mehmetalialkan/T3-Planner/T3-Redstone/mekanik/t3-redstone-outline.dxf

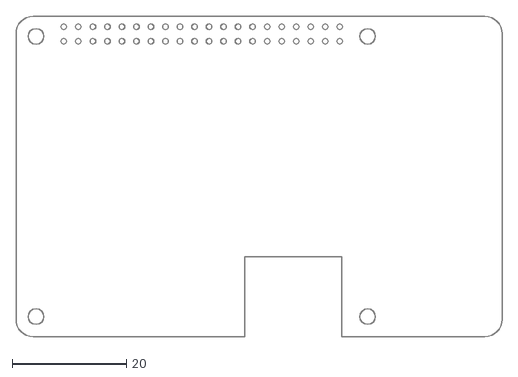
[picture p1: CAD file, 2026-09-13]
T3-Redstone/mekanik/t3-redstone-outline.dxf
85.0 x 56.0
