mehmetalialkan/T3-Planner/T3-Redstone/kicad/t3-redstone.kicad_pcb

## KiCad design T3-Redstone/kicad/t3-redstone.kicad_pcb (2026-09-13)

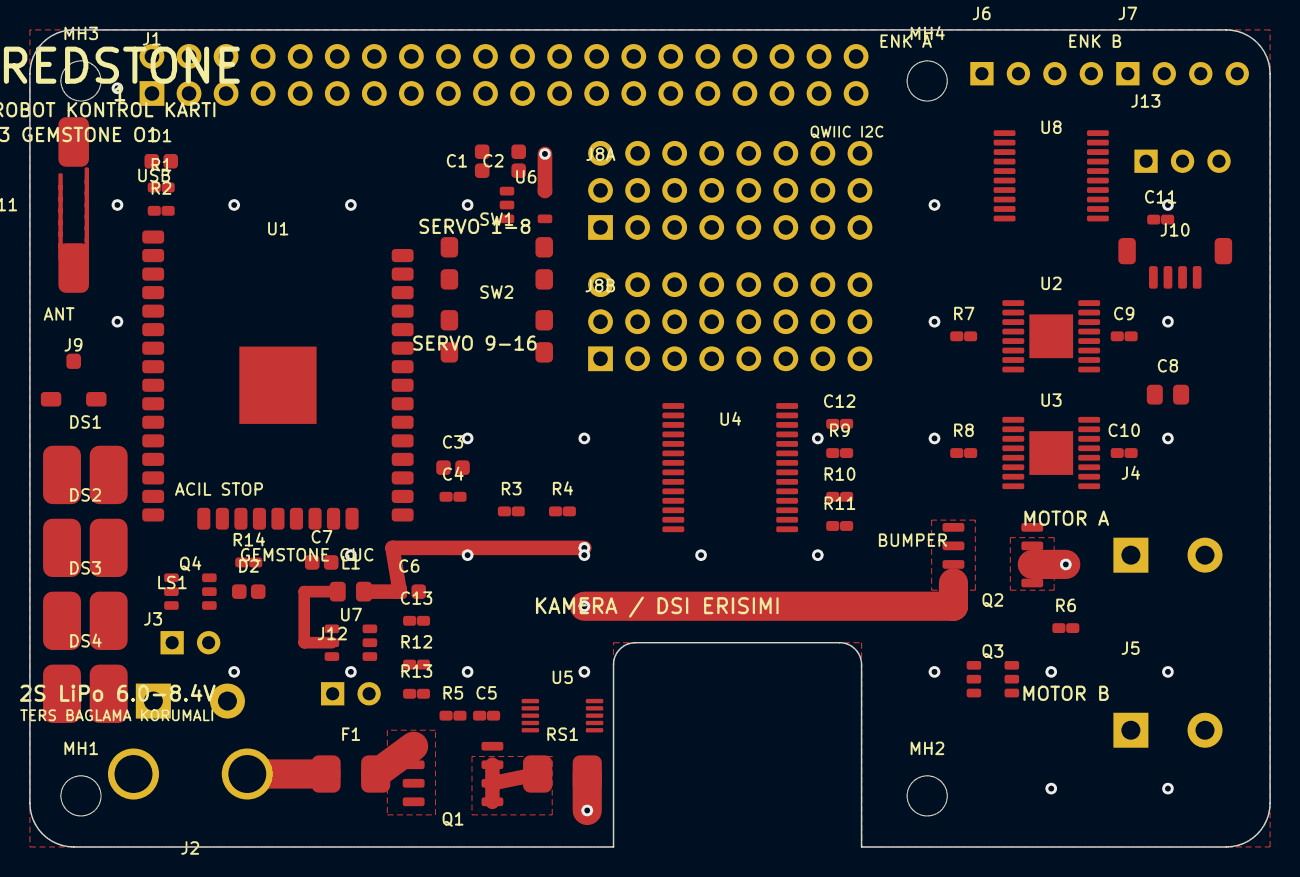
[picture p2: board t3-redstone.kicad_pcb from above]

Board: 4 copper layers, 85.0 x 56.0 mm, 69 parts (0 on the bottom side), 72 nets.

Parts:
C1: 10u; C1
C2: 10u; C2
C3: 22u; C3
C4: 100n; C4
C5: 100n; C5
C6: 22u; C6
C7: 10u; C7
C8: 100u; C8
C9: 100n; C9
C10: 100n; C10
C11: 100n; C11
C12: 100n; C12
C13: 100n; C13
D1: SS14 SOD123; D1
D2: SS14; D2
DS1: WS2812B; DS1
DS2: WS2812B; DS2
DS3: WS2812B; DS3
DS4: WS2812B; DS4
F1: 20A; F1
J1: GEMSTONE_40P_DISI; J1
J2: XT60 2S LiPo; J2
J3: GEMSTONE GUC; J3
J4: MOTOR A; J4
J5: MOTOR B; J5
J6: ENKODER A; J6
J7: ENKODER B; J7
J8A: SERVO 1-8; J8A
J8B: SERVO 9-16; J8B
J9: U.FL ANT; J9
J10: QWIIC; J10
J11: USB-C; J11
J12: ESTOP BUTON; J12
J13: BUMPER; J13
L1: 4u7; L1
LS1: BUZZER; LS1
MH1: M2.5; MH1
MH2: M2.5; MH2
MH3: M2.5; MH3
MH4: M2.5; MH4
Q1: P-MOSFET; Q1
Q2: P-FET ESTOP; Q2
Q3: N-FET SOT23; Q3
Q4: N-FET SOT23; Q4
R1: 5k1; R1
R2: 5k1; R2
R3: 10k; R3
R4: 10k; R4
R5: 100k; R5
R6: 100k; R6
R7: 1k5; R7
R8: 1k5; R8
R9: 10k; R9
R10: 4k7; R10
R11: 4k7; R11
R12: 68k; R12
R13: 10k; R13
R14: 10k; R14
RS1: 2m 2W; RS1
SW1: BOOT; SW1
SW2: RESET; SW2
U1: ESP32-S3-WROOM-1U; U1
U2: DRV8874 A; U2
U3: DRV8874 B; U3
U4: PCA9685; U4
U5: INA226; U5
U6: AP2112K-3.3; U6
U7: TPS563201 5V; U7
U8: 74LVC245; U8

Connections:
+3V3: C2.1, C3.1, C4.1, C5.1, C11.1, C12.1, D2.2, J10.2, LS1.1, R3.2, R4.2, R10.2, R11.2, U1.2, U2.7, U3.7, U4.28, U5.7, U5.10, U6.5, U8.1, U8.20
+5V: C1.1, C6.1, D1.2, J6.1, J7.1, J8A.2, J8A.5, J8A.8, J8A.11, J8A.14, J8A.17, J8A.20, J8A.23, J8B.2, J8B.5, J8B.8, J8B.11, J8B.14, J8B.17, J8B.20, J8B.23, L1.2, R12.1, U6.1, U6.3
+5V_FB: R12.2, R13.1, U7.4
+5V_USB: D1.1, J11.A4, J11.A9, J11.B4, J11.B9
BOOT5V: C13.1, U7.6
BOOT_BTN: SW1.1, SW1.2, U1.27
BUMP1: J13.2, U1.30
BUMP2: J13.3, U1.29
BUZZER: J1.37, Q4.1, R14.1
BUZZER_DRV: D2.1, LS1.2, Q4.3
CC1: J11.A5, R1.1
CC2: J11.B5, R2.1
DRV_nFAULT: R4.1, U1.9, U2.5, U3.5
DRV_nSLEEP: U1.8, U2.2, U3.2
EN: R3.1, SW2.1, SW2.2, U1.3
ENC_A1: U1.12, U8.18
ENC_A1_5V: J6.3, U8.2
ENC_A2: U1.11, U8.16
ENC_A2_5V: J7.3, U8.4
ENC_B1: U1.10, U8.17
ENC_B1_5V: J6.4, U8.3
ENC_B2: U1.17, U8.15
ENC_B2_5V: J7.4, U8.5
ESTOP_BTN: J12.1, U1.32
ESTOP_DRV: Q3.1, U1.23
ESTOP_GATE: Q2.4, Q3.3, R6.1
ESTOP_STAT: J1.13, U1.20
GND: C1.2, C2.2, C3.2, C4.2, C5.2, C6.2, C7.2, C8.2, C9.2, C10.2, C11.2, C12.2, J1.6, J1.9, J1.14, J1.20, J1.25, J1.30, J1.34, J1.39, J2.2, J3.2, J6.2, J7.2, J8A.3, J8A.6, J8A.9, J8A.12, J8A.15, J8A.18, J8A.21, J8A.24, J8B.3, J8B.6, J8B.9, J8B.12, J8B.15, J8B.18, J8B.21, J8B.24, J9.2, J10.1, J10.MP1, J10.MP2, J11.A1, J11.A12, J11.B1, J11.B12, J11.S1, J11.S2, J12.2, J13.1, Q3.2, Q4.2, R1.2, R2.2, R5.2, R7.2, R8.2, R9.2, R13.2, R14.2, SW1.3, SW1.4, SW2.3, SW2.4, U1.1, U1.40, U1.41, U2.6, U2.8, U2.10, U2.11, U2.EP, U3.6, U3.8, U3.10, U3.11, U3.EP, U4.1, U4.2, U4.3, U4.4, U4.5, U4.6, U4.14, U4.25, U5.4, U5.8, U6.2, U7.1, U8.6, U8.7, U8.8, U8.9, U8.10, U8.19
GND_GATE: Q1.4, R5.1
HOST_RX: J1.10, U1.25
HOST_TX: J1.8, U1.24
I2C_SCL: J10.4, R11.1, U1.35, U4.26, U5.5
I2C_SDA: J10.3, R10.1, U1.34, U4.27, U5.6
IPROPI_A: R7.1, U1.39, U2.1
IPROPI_B: R8.1, U1.38, U3.1
LED_D1: DS1.2, DS2.1
LED_D2: DS2.2, DS3.1
LED_D3: DS3.2, DS4.1
LED_DATA: DS1.1, U1.31
MA_EN: U1.5, U2.3
MA_PH: U1.4, U2.4
MB_EN: U1.7, U3.3
MB_PH: U1.6, U3.4
OE_N: R9.1, U4.24
OUTA1: J4.1, U2.13, U2.16
OUTA2: J4.2, U2.9, U2.12
OUTB1: J5.1, U3.13, U3.16
OUTB2: J5.2, U3.9, U3.12
SERVO1: J8A.1, U4.7
SERVO2: J8A.4, U4.8
SERVO3: J8A.7, U4.9
SERVO4: J8A.10, U4.10
SERVO5: J8A.13, U4.11
SERVO6: J8A.16, U4.12
SERVO7: J8A.19, U4.13
SERVO8: J8A.22, U4.15
SERVO9: J8B.1, U4.16
SERVO10: J8B.4, U4.17
SERVO11: J8B.7, U4.18
SERVO12: J8B.10, U4.19
SERVO13: J8B.13, U4.20
SERVO14: J8B.16, U4.21
SERVO15: J8B.19, U4.22
SERVO16: J8B.22, U4.23
SW5V: C13.2, L1.1, U7.2
USB_DM: J11.A7, J11.B7, U1.13
USB_DP: J11.A6, J11.B6, U1.14
VBAT: Q1.1, Q1.2, Q1.3, RS1.1, U5.1
VBAT_F: F1.2, Q1.5, Q1.6, Q1.7, Q1.8
VBAT_RAW: F1.1, J2.1
VBAT_SW: C8.1, C9.1, C10.1, Q2.1, Q2.2, Q2.3, U2.14, U2.15, U3.14, U3.15
VSYS: C7.1, J3.1, Q2.5, Q2.6, Q2.7, Q2.8, R6.2, RS1.2, U5.2, U5.9, U7.3, U7.5
