mehmetalialkan/T3-Planner/(commit log)

2026-09-13 T3-Redstone: Gemstone O1 analizi ve kart tasarim paketi
    Gemstone O1'in dokumanlari, blok diyagrami, layout PDF'i ve Fritzing PCB
    dosyasi incelendi. Bulgular:
    - Kart 85x56 mm, montaj delikleri 58x49 mm -> Raspberry Pi Model B form faktoru
    - 40-pin header pinout'u BCM ile birebir ayni
    - EQEP0/EQEP1 donanim enkoder sayicilari HAT'e cikmis (dokumanlarda gecmiyor)
    - PWM periyot tuzagi: pwmchip3 ve pwmchip5 kanal ciftleri periyot paylasiyor
    - Kartta hic ADC yok
    - DC giris araligi iki kaynakta celisiyor (5-12V vs 5-9V) -> 2S LiPo ile guvende
    Eklenenler:
    - Acilabilir KiCad 8 board dosyasi (kontur, montaj delikleri, 2x20 header,
    Gemstone referans konturu, USB/RJ45 yasak bolgesi)
    - Kontur DXF'i ve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
    [bom.csv, t3-redstone-outline.dxf, t3-redstone.kicad_pcb]
2026-09-13 Redstone: tam boy 85x56, kamera/DSI kesiti, 2x20 disi soket
    - Kart 65x56.5 (RPi HAT) yerine Gemstone ile ayni tam boy 85x56 mm
    - Alt kenara acik U kesit: J4 (CSI) ve J12 (CSI/DSI) konnektorlerine
    kablo ve parmak erisimi. Konum parametrik (CUT_X1/CUT_X2/CUT_DEPTH),
    fotograftan tahmin - kumpasla dogrulanacak
    - 2x20 erkek header yerine disi soket (PinSocket_2x20)
    - Tam boy shield USB-A yigini ve RJ45 uzerinden gectigi icin en az 16mm
    gecis yuksekliginde soket ve standoff sart; Dwgs.User katmaninda
    yuksek konnektor bolgeleri isaretlendi
    - Edge.Cuts konturu kapali dogrulandi (14 segment, 85.00x56.00)
    Claude-Session: https://claude.ai/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
    [t3-redstone-outline.dxf, t3-redstone.kicad_pcb]
2026-09-13 Redstone: tam yerlesim, 4 katman guc duzlemleri, kirmizi maske
    Board ureteci yazildi (rs_lib / rs_design / rs_emit / rs_render):
    - 69 komponent, 84 net, parametrik footprint kutuphanesi (SOIC/TSSOP/SOT/
    chip/header/terminal/JST/XT60/USB-C/WROOM-1U)
    - Kat plani: sol-ust USB+anten+LED, sol-orta ESP32, sol-alt guc zinciri,
    orta servo+PCA9685, sag-ust enkoder+tampon, sag motor surucu+klemens
    - 4 katman: F.Cu sinyal / In1.Cu tam GND duzlemi / In2.Cu bolunmus guc
    duzlemi (VSYS, +3V3, +5V, VBAT_SW - cakismasiz) / B.Cu sinyal+GND
    - Kirmizi lehim maskesi ve ENIG stackup'ta tanimli
    - Guc zinciri yollari + 33 GND dikis viasi
    - Yuksek akimli dugumler yol yerine yerel F.Cu bakir alani ile cozuldu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
    [t3-redstone-outline.dxf, t3-redstone.kicad_pcb]
